Jianghanlin/Res_Measure_System/README.md

# Res_Measure_System
基于MSP430G2553的电阻测量系统
