Jianghanlin/Res_Measure_System/(list of files, cad)

Other CAD files:
Measure_Resist/Debug/src/LCD_128.obj
Measure_Resist/Debug/src/HT1621.obj
Measure_Resist/Debug/src/TCA6416A.obj
Measure_Resist/Debug/src/I2C.obj
