Jianghanlin/Res_Measure_System/(list of files, drawings)

Other design files:
题目一 电阻测量系统设计/仿真/单片机课程设计.pdsprj
